noahwrivas/School-Projects/Smart Home/Images/Analog Circuit (b).PNG

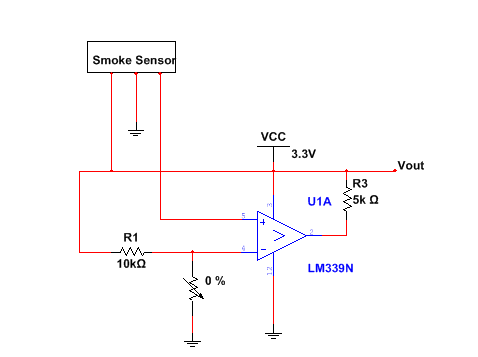
Smart Home/Images/Analog Circuit (b).PNG
