noahwrivas/School-Projects/Smart Home/Images/Analog Circuit (c).PNG

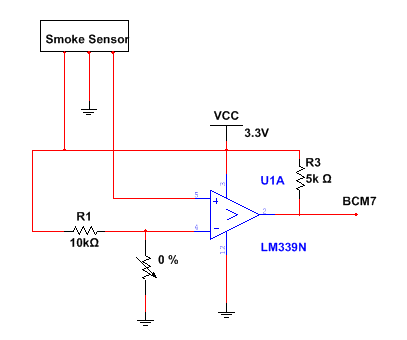
Smart Home/Images/Analog Circuit (c).PNG
