noahwrivas/School-Projects/Smart Home/Images/Buzzer Driver.PNG

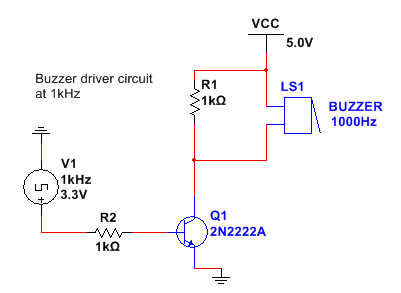
Smart Home/Images/Buzzer Driver.PNG
