noahwrivas/School-Projects/Smart Home/Images/Smoke Sim.jpg

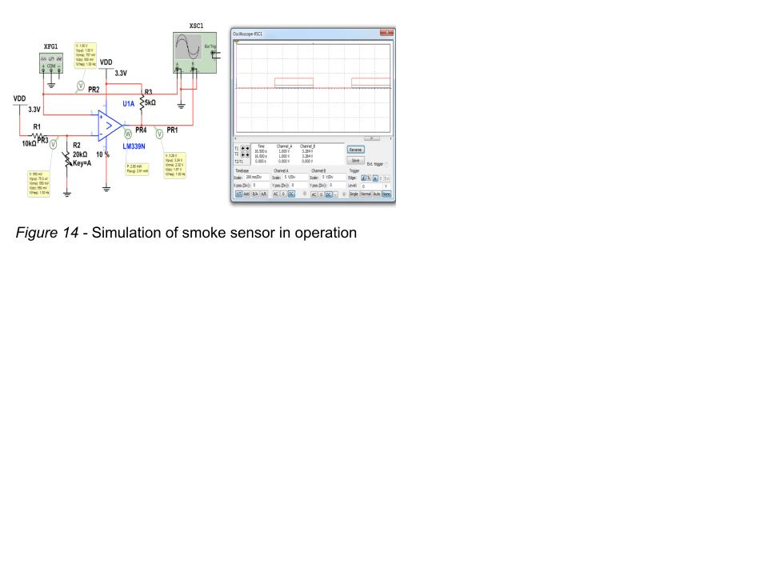
Smart Home/Images/Smoke Sim.jpg
